UAlberta-EcoCar/Relay-Board-2017-2018/Relay Board 2018 Parts List.xlsx

Relay Board Digikey List 2018
Part Description | Quantity | Store # | Store
8AWG Wire-to-Board Connector | 10 | 732-3204-ND
Switch (Voltage Divider) | 3 | EG1903-ND
Resistor 0603 (10.5k ohm) | 3 | P10.5KDBCT-ND
Resistor 0603 (768 ohm) | 3 | P768HCT-ND
Resistor 0603 (1.5k ohm) | 3 | P1.5KDBCT-ND
TVS Diode | 2 | P6KE15A-E3/54GICT-ND
RJ-11 | 3 | A119660-ND
RJ-45 | 2 | A122645-ND
Power Board Relay | 1 | CLA394-ND
Current Sensor (50A) | 2 | 620-1541-5-ND
Current Sensor (100A) | 1 | 620-1544-5-ND
Capacitor 0603 (0.1uF) | 3 | 399-1096-1-ND
Resistor 0603 (10k ohm) | 4 | RHM10KDCT-ND
Resistor 0603 (470 ohm) | 4 | RHM470DCT-ND
Photocoupler | 4 | H11L1-MQT-ND
P-MOS | 4 | DMP3056L-7DICT-ND
Flyback Diode | 4 | MUR420RLGOSCT-ND
Relay Socket | 4 | PB232-ND
90A Relay | 2 | 255-5246-ND
