UAlberta-EcoCar/Relay-Board-2017-2018/Relay_Board_V3.5.brd

## EAGLE design Relay_Board_V3.5.brd (2018-01-20)

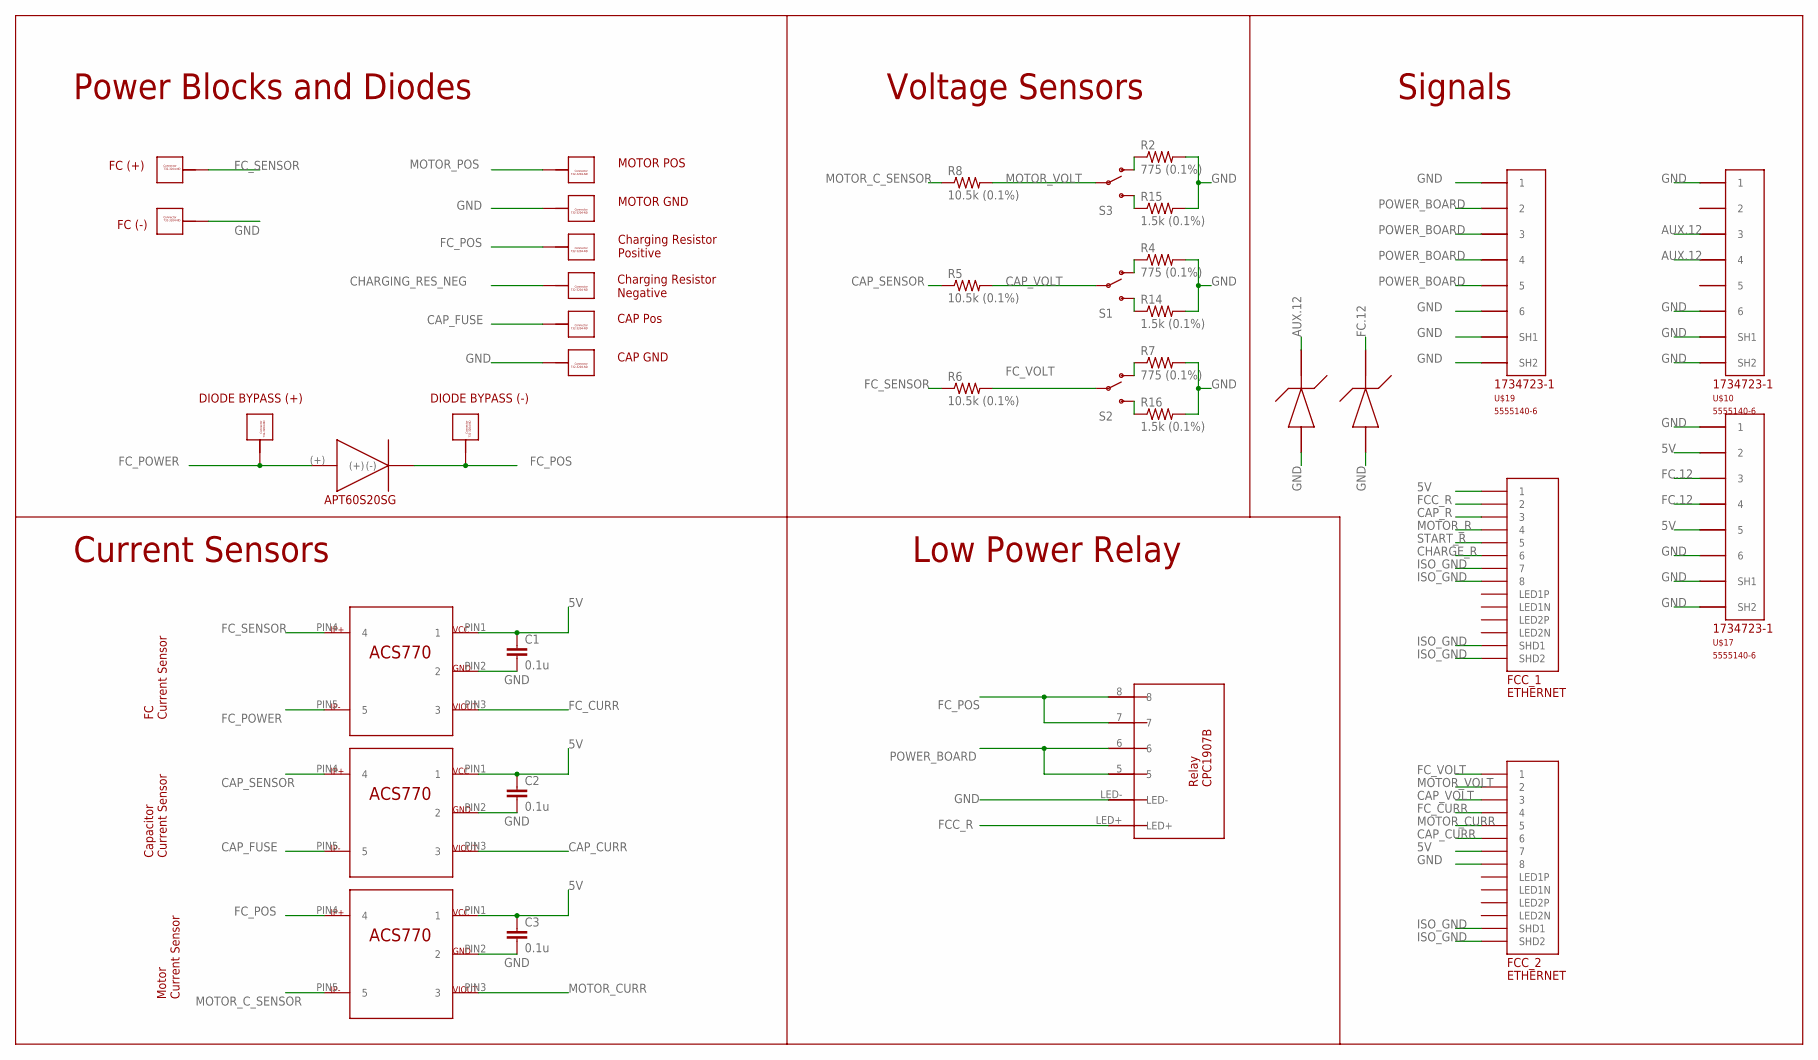
[picture p1: schematic Relay_Board_V3.5.sch, sheet 1]

Parts:
C1, C2, C3: 0.1u; 0603-CAP
CAP.GND, CAP.POS, CAP.POS1, CAP.POS2: 732-3204-ND_CONNECTOR; 732-3204-ND
D1: APT60S20SG; TO268
FC.GND, FC.POS: 732-3204-ND_CONNECTOR; 732-3204-ND
FCC_1, FCC_2: ETHERNET; A122645-ND
MOTOR.GROUND, MOTOR.POSITIVE: 732-3204-ND_CONNECTOR; 732-3204-ND
R2, R4, R7: 775 (0.1%); R0805
R5, R6, R8: 10.5k (0.1%); R0805
R14, R15, R16: 1.5k (0.1%); R0805
RES.NEG, RES.POS: 732-3204-ND_CONNECTOR; 732-3204-ND
S1, S2, S3: SWITCH-SPDTPTH; SWITCH-SPDT
U$7, U$8, U$9: ACS770LCB_CURRENTSENSOR
U$10, U$17, U$19: 5555140-6; 1734723-1_RJ11
U$15, U$16: P6KE15A-E3/54GICT-ND_TVS_DIODE
U$22: RELAY-CPC1907B

Connections:
5V: C1.1, C2.1, C3.1, FCC_1.P$1 (1), FCC_2.P$7 (7), U$7.PIN1 (1), U$8.PIN1 (1), U$9.PIN1 (1), U$17.2, U$17.5
AUX.12: U$10.3, U$10.4, U$16.P$2 (P(-)); also elsewhere on the board
CAP_CURR: FCC_2.P$6 (6), U$8.PIN3 (3)
CAP_FUSE: CAP.POS.P$1, CAP.POS.P$2, CAP.POS.P$3, CAP.POS.P$4, CAP.POS.P$5, CAP.POS.P$6, CAP.POS.P$7, CAP.POS.P$8, CAP.POS.P$9, CAP.POS.P$10, U$8.PIN5 (5)
CAP_R: FCC_1.P$3 (3); also elsewhere on the board
CAP_SENSOR: R5.1, U$8.PIN4 (4); also elsewhere on the board
CAP_VOLT: FCC_2.P$3 (3), R5.2, S1.2
CHARGE_R: FCC_1.P$6 (6); also elsewhere on the board
CHARGING_RES_NEG: RES.NEG.P$1, RES.NEG.P$2, RES.NEG.P$3, RES.NEG.P$4, RES.NEG.P$5, RES.NEG.P$6, RES.NEG.P$7, RES.NEG.P$8, RES.NEG.P$9, RES.NEG.P$10; also elsewhere on the board
FC.12: U$15.P$2 (P(-)), U$17.3, U$17.4; also elsewhere on the board
FCC_R: FCC_1.P$2 (2), U$22.LED+
FC_CURR: FCC_2.P$4 (4), U$7.PIN3 (3)
FC_POS: CAP.POS2.P$1, CAP.POS2.P$2, CAP.POS2.P$3, CAP.POS2.P$4, CAP.POS2.P$5, CAP.POS2.P$6, CAP.POS2.P$7, CAP.POS2.P$8, CAP.POS2.P$9, CAP.POS2.P$10, D1.(-), D1.C@1 ((-)), D1.C@2 ((-)), RES.POS.P$1, RES.POS.P$2, RES.POS.P$3, RES.POS.P$4, RES.POS.P$5, RES.POS.P$6, RES.POS.P$7, RES.POS.P$8, RES.POS.P$9, RES.POS.P$10, U$9.PIN4 (4), U$22.7, U$22.8; also elsewhere on the board
FC_POWER: CAP.POS1.P$1, CAP.POS1.P$2, CAP.POS1.P$3, CAP.POS1.P$4, CAP.POS1.P$5, CAP.POS1.P$6, CAP.POS1.P$7, CAP.POS1.P$8, CAP.POS1.P$9, CAP.POS1.P$10, D1.(+), U$7.PIN5 (5)
FC_SENSOR: FC.POS.P$1, FC.POS.P$2, FC.POS.P$3, FC.POS.P$4, FC.POS.P$5, FC.POS.P$6, FC.POS.P$7, FC.POS.P$8, FC.POS.P$9, FC.POS.P$10, R6.1, U$7.PIN4 (4)
FC_VOLT: FCC_2.P$1 (1), R6.2, S2.2
GND: C1.2, C2.2, C3.2, CAP.GND.P$1, CAP.GND.P$2, CAP.GND.P$3, CAP.GND.P$4, CAP.GND.P$5, CAP.GND.P$6, CAP.GND.P$7, CAP.GND.P$8, CAP.GND.P$9, CAP.GND.P$10, FC.GND.P$1, FC.GND.P$2, FC.GND.P$3, FC.GND.P$4, FC.GND.P$5, FC.GND.P$6, FC.GND.P$7, FC.GND.P$8, FC.GND.P$9, FC.GND.P$10, FCC_2.P$8 (8), MOTOR.GROUND.P$1, MOTOR.GROUND.P$2, MOTOR.GROUND.P$3, MOTOR.GROUND.P$4, MOTOR.GROUND.P$5, MOTOR.GROUND.P$6, MOTOR.GROUND.P$7, MOTOR.GROUND.P$8, MOTOR.GROUND.P$9, MOTOR.GROUND.P$10, R2.2, R4.2, R7.2, R14.2, R15.2, R16.2, U$7.PIN2 (2), U$8.PIN2 (2), U$9.PIN2 (2), U$10.1, U$10.6, U$10.SH1, U$10.SH2, U$15.P$1 (P(+)), U$16.P$1 (P(+)), U$17.1, U$17.6, U$17.SH1, U$17.SH2, U$19.1, U$19.6, U$19.SH1, U$19.SH2, U$22.LED-; also elsewhere on the board
ISO_GND: FCC_1.P$7 (7), FCC_1.P$8 (8), FCC_1.P$13 (SHD1), FCC_1.P$14 (SHD2), FCC_2.P$13 (SHD1), FCC_2.P$14 (SHD2); also elsewhere on the board
MOTOR_CURR: FCC_2.P$5 (5), U$9.PIN3 (3)
MOTOR_C_SENSOR: R8.1, U$9.PIN5 (5); also elsewhere on the board
MOTOR_POS: MOTOR.POSITIVE.P$1, MOTOR.POSITIVE.P$2, MOTOR.POSITIVE.P$3, MOTOR.POSITIVE.P$4, MOTOR.POSITIVE.P$5, MOTOR.POSITIVE.P$6, MOTOR.POSITIVE.P$7, MOTOR.POSITIVE.P$8, MOTOR.POSITIVE.P$9, MOTOR.POSITIVE.P$10; also elsewhere on the board
MOTOR_R: FCC_1.P$4 (4); also elsewhere on the board
MOTOR_VOLT: FCC_2.P$2 (2), R8.2, S3.2
unnamed: R4.1, S1.1 (O)
unnamed: R14.1, S1.3 (S)
unnamed: R2.1, S3.1 (O)
unnamed: R15.1, S3.3 (S)
unnamed: R7.1, S2.1 (O)
unnamed: R16.1, S2.3 (S)
POWER_BOARD: U$19.2, U$19.3, U$19.4, U$19.5, U$22.5, U$22.6
START_R: FCC_1.P$5 (5); also elsewhere on the board

Notes on the sheet:
FC Current Sensor
Charging Resistor Positive
Charging Resistor Negative
Motor Current Sensor
FC (+)
FC (-)
Voltage Sensors
Power Blocks and Diodes
Signals
DIODE BYPASS (+)
DIODE BYPASS (-)
Current Sensors
Capacitor Current Sensor
CAP Pos
CAP GND
MOTOR GND
MOTOR POS
Low Power Relay

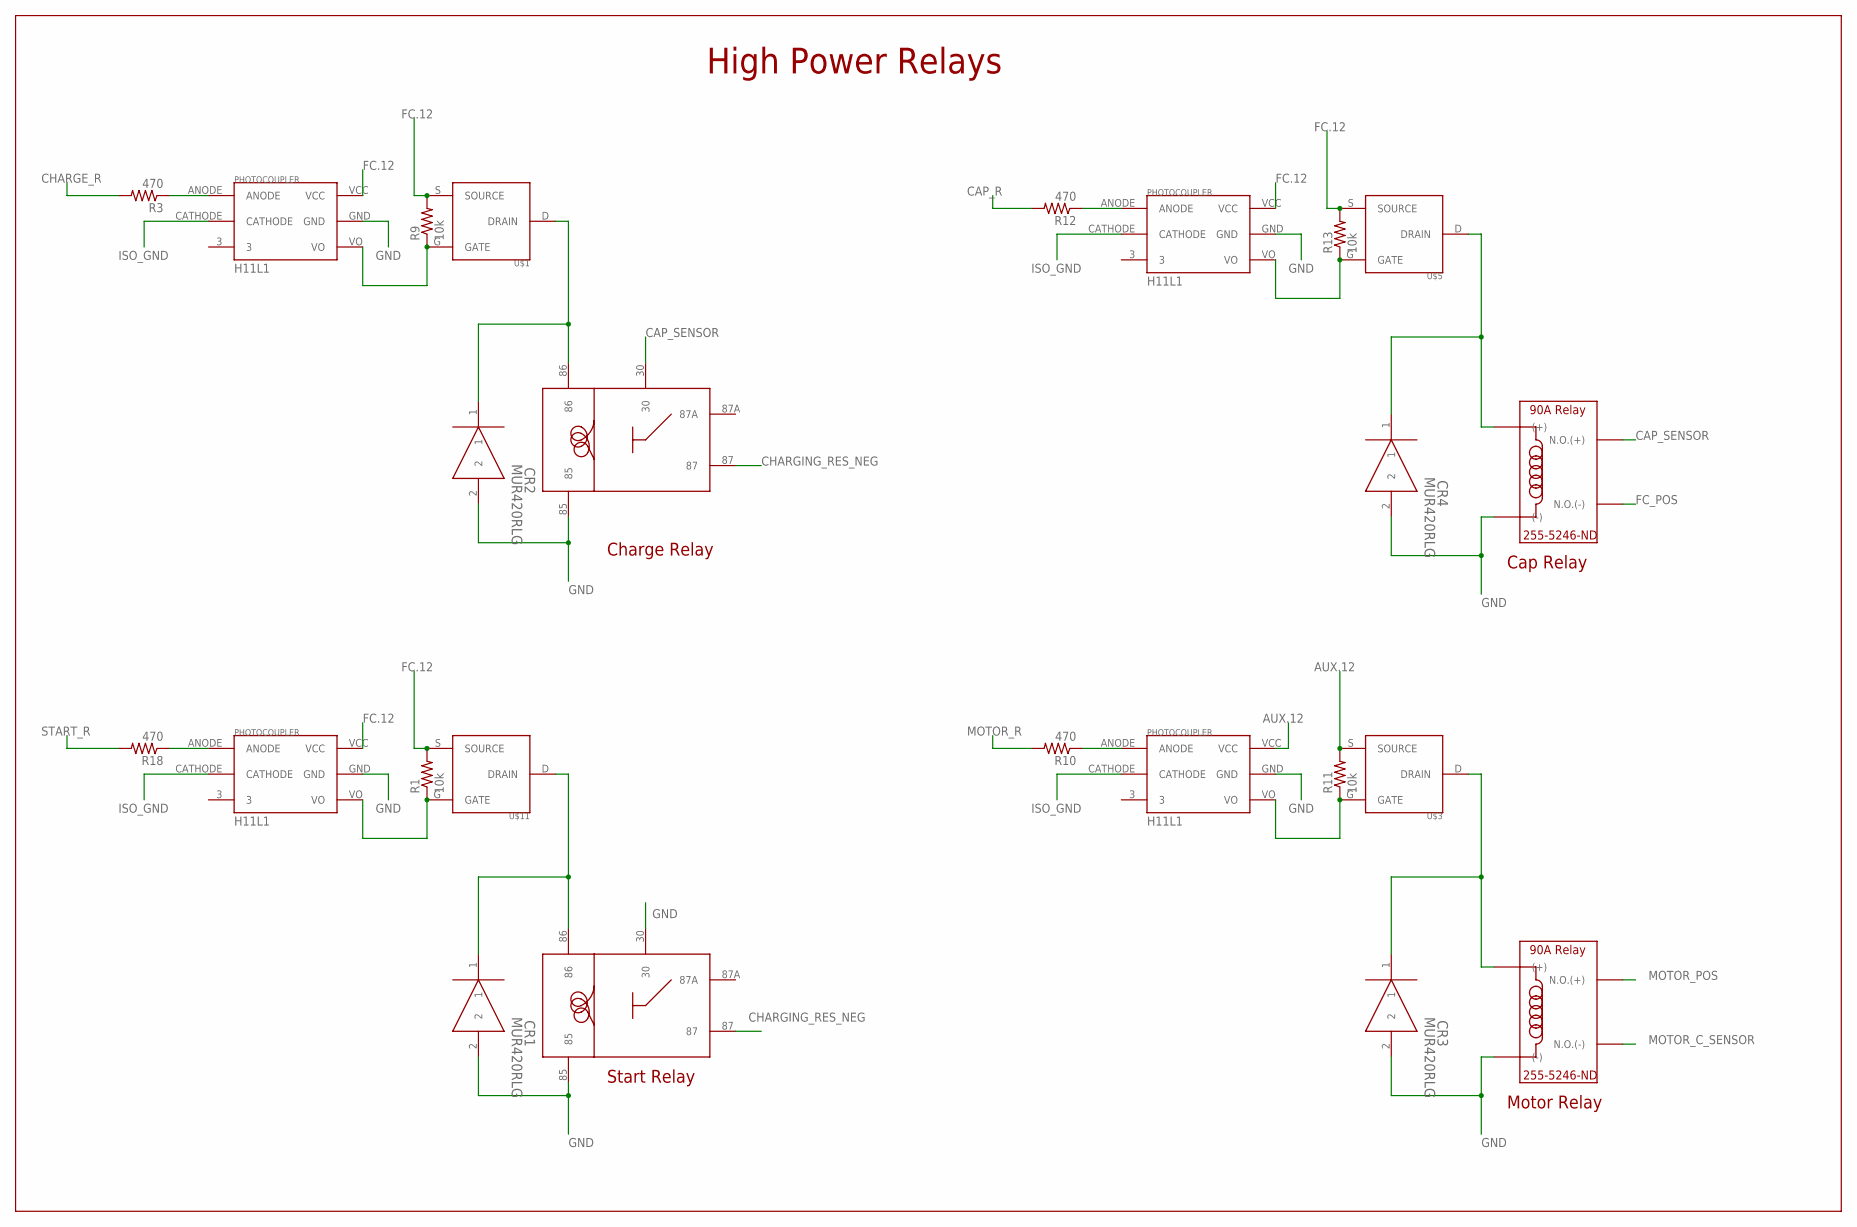
[picture p2: schematic Relay_Board_V3.5.sch, sheet 2]

Parts:
CR1, CR2, CR3, CR4: MUR420RLG; DO-201AD
R1, R9, R11, R13: 10k; 0603-RES
R3, R10, R12, R18: 470; 0603-RES
START.RELAY1, START.RELAY2: VCF4-1000
U$1, U$3, U$5, U$11: DMP3056L-7DMP3056L-7; DMP3056L-7
U$2, U$4, U$6, U$12: H11L1H11L1; H11L1
U$13, U$14: 255-5246-ND

Connections:
AUX.12: R11.2, U$3.S (SOURCE), U$4.VCC; also elsewhere on the board
CAP_R: R12.2; also elsewhere on the board
CAP_SENSOR: START.RELAY2.30, U$13.NO(+) (N.O.(+)), U$13.NO(++) (N.O.(+)); also elsewhere on the board
CHARGE_R: R3.2; also elsewhere on the board
CHARGING_RES_NEG: START.RELAY1.87, START.RELAY2.87; also elsewhere on the board
FC.12: R1.2, R9.2, R13.2, U$1.S (SOURCE), U$2.VCC, U$5.S (SOURCE), U$6.VCC, U$11.S (SOURCE), U$12.VCC; also elsewhere on the board
FC_POS: U$13.NO(-) (N.O.(-)), U$13.NO(--) (N.O.(-)); also elsewhere on the board
GND: CR1.2, CR2.2, CR3.2, CR4.2, START.RELAY1.30, START.RELAY1.85, START.RELAY2.85, U$2.GND, U$4.GND, U$6.GND, U$12.GND, U$13.(-), U$13.(--) ((-)), U$14.(-), U$14.(--) ((-)); also elsewhere on the board
ISO_GND: U$2.CATHODE, U$4.CATHODE, U$6.CATHODE, U$12.CATHODE; also elsewhere on the board
MOTOR_C_SENSOR: U$14.NO(-) (N.O.(-)), U$14.NO(--) (N.O.(-)); also elsewhere on the board
MOTOR_POS: U$14.NO(+) (N.O.(+)), U$14.NO(++) (N.O.(+)); also elsewhere on the board
MOTOR_R: R10.2; also elsewhere on the board
unnamed: R9.1, U$1.G (GATE), U$2.VO
unnamed: R3.1, U$2.ANODE
unnamed: CR2.1, START.RELAY2.86, U$1.D (DRAIN)
unnamed: R11.1, U$3.G (GATE), U$4.VO
unnamed: R10.1, U$4.ANODE
unnamed: CR3.1, U$3.D (DRAIN), U$14.(+), U$14.(++) ((+))
unnamed: R13.1, U$5.G (GATE), U$6.VO
unnamed: R12.1, U$6.ANODE
unnamed: CR4.1, U$5.D (DRAIN), U$13.(+), U$13.(++) ((+))
unnamed: R1.1, U$11.G (GATE), U$12.VO
unnamed: R18.1, U$12.ANODE
unnamed: CR1.1, START.RELAY1.86, U$11.D (DRAIN)
START_R: R18.2; also elsewhere on the board

Notes on the sheet:
Start Relay
Charge Relay
High Power Relays
Motor Relay
Cap Relay

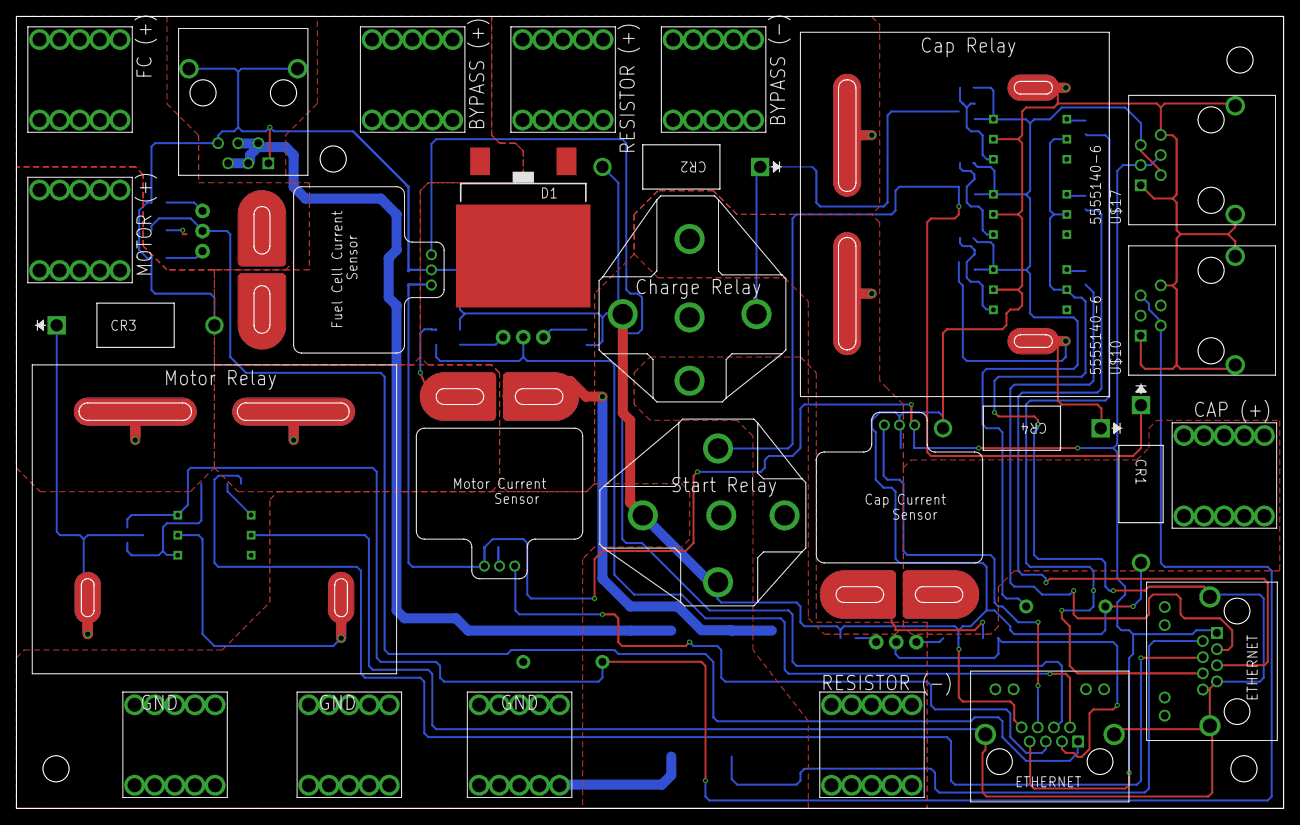
[picture p3: board Relay_Board_V3.5.brd from above]

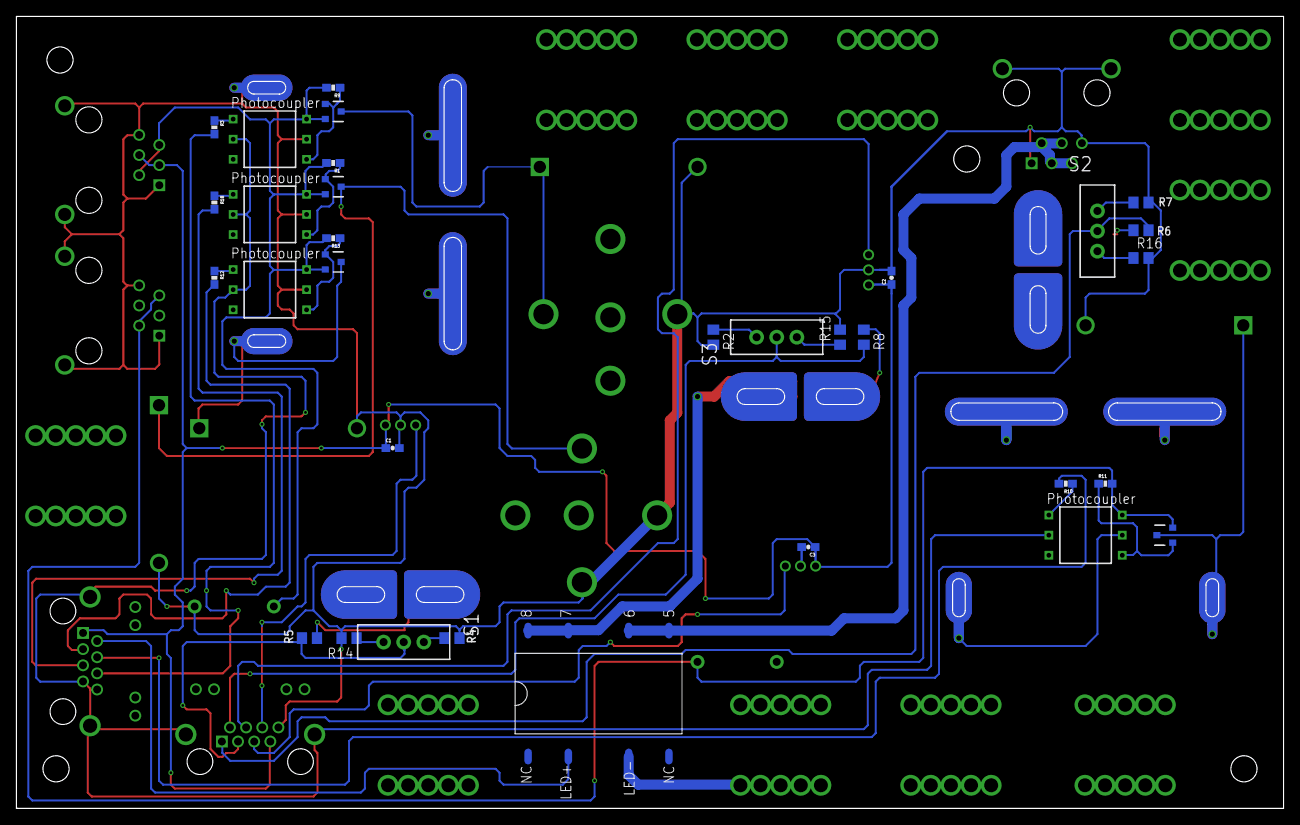
[picture p4: board Relay_Board_V3.5.brd from below]

Board: 2 copper layers, 160.0 x 100.0 mm, 65 parts (32 on the bottom side), 43 nets.

Other parts of the board:
U$18, U$20, U$21, U$23: STAND-OFF
