UAlberta-EcoCar/Relay-Board-2017-2018/(commit log)

2017-10-21 Relay Board V3 added
    [Relay_Board_V3.brd, Relay_Board_V3.sch]
2017-10-28 Schematic Complete
    [Relay_Board_V3.1.brd, Relay_Board_V3.1.sch]
2017-11-04 Major Trace Routes
    [Relay_Board_V3.1.brd]
2017-11-13 Board Routed
    [Relay_Board_V3.1.brd, Relay_Board_V3.1.sch]
2017-12-01 Board Complete for 2017
    [Relay_Board_V3.2.brd, Relay_Board_V3.2.sch]
2017-12-02 Updated OptoIsolator Part so it is same as FCC
    [Relay_Board_V3.2.brd, Relay_Board_V3.2.sch]
2017-12-02 Added Labels to Ethernet connectors
    [Relay_Board_V3.2.brd, Relay_Board_V3.2.sch]
2017-12-02 Added RJ-11
    [Relay_Board_V3.2.brd, Relay_Board_V3.2.sch]
2017-12-02 Schematic Fix
    [Relay_Board_V3.3.brd, Relay_Board_V3.3.sch]
2017-12-05 Gerbers Generated
    [Relay_Board_V3.1.brd, Relay_Board_V3.1.sch, Relay_Board_V3.2.brd, Relay_Board_V3.2.sch, Relay_Board_V3.3.brd, Relay_Board_V3.brd, Relay_Board_V3.sch]
2018-01-17 Fixed RJ-11 and thermals
    [Relay_Board_V3.4.brd, Relay_Board_V3.4.sch]
2018-01-20 Fixed Traced Separation
    [Relay_Board_V3.4.GBL, Relay_Board_V3.4.GBO, Relay_Board_V3.4.GBP, Relay_Board_V3.4.GBS, Relay_Board_V3.4.GTL, Relay_Board_V3.4.GTO, Relay_Board_V3.4.GTP, Relay_Board_V3.4.GTS]
2018-01-21 Added Parts List
    [Relay Board 2018 Parts List.xlsx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]
